Azow/Capstone-Robot-Camera-Arm/src/arm_description_v2/meshes/Carriage.STL

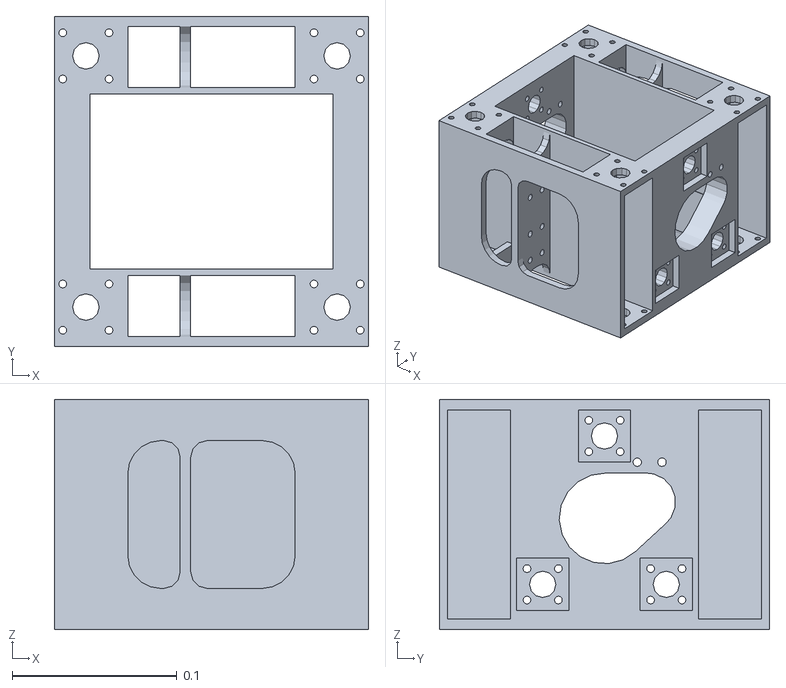
[picture p1: CAD file, 2026-10-30]
src/arm_description_v2/meshes/Carriage.STL
0.191 x 0.2 x 0.14
