Azow/Capstone-Robot-Camera-Arm/src/arm_description_v2/Robotic Camera Arm Prototype Assem 1.SLDASM/meshes/Yaw_Gimbal.STL

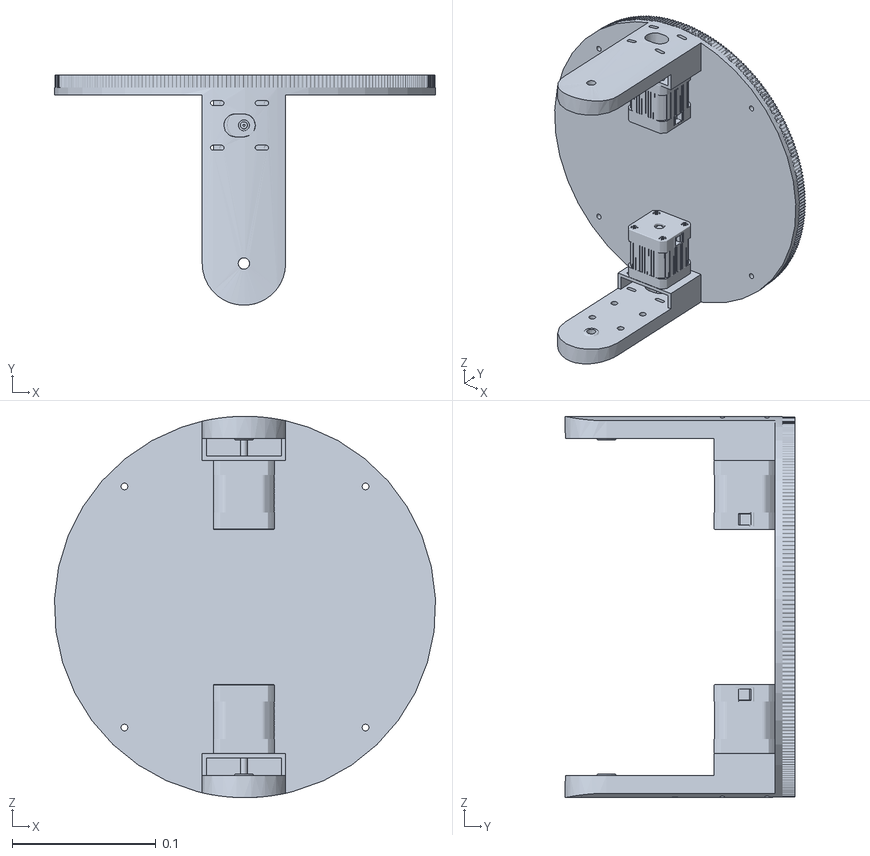
[picture p2: CAD file, 2026-10-30]
src/arm_description_v2/Robotic Camera Arm Prototype Assem 1.SLDASM/meshes/Yaw_Gimbal.STL
0.265 x 0.16 x 0.265
