Azow/Capstone-Robot-Camera-Arm/src/arm_description_v2/meshes/base_link.STL

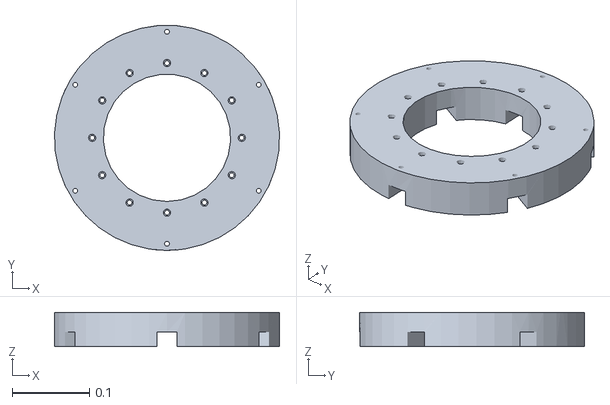
[picture p3: CAD file, 2026-10-30]
src/arm_description_v2/meshes/base_link.STL
0.292 x 0.292 x 0.0445
