Azow/Capstone-Robot-Camera-Arm/src/arm_description_v2/Robotic Camera Arm Prototype Assem 1.SLDASM/meshes/Rotating_Base.STL

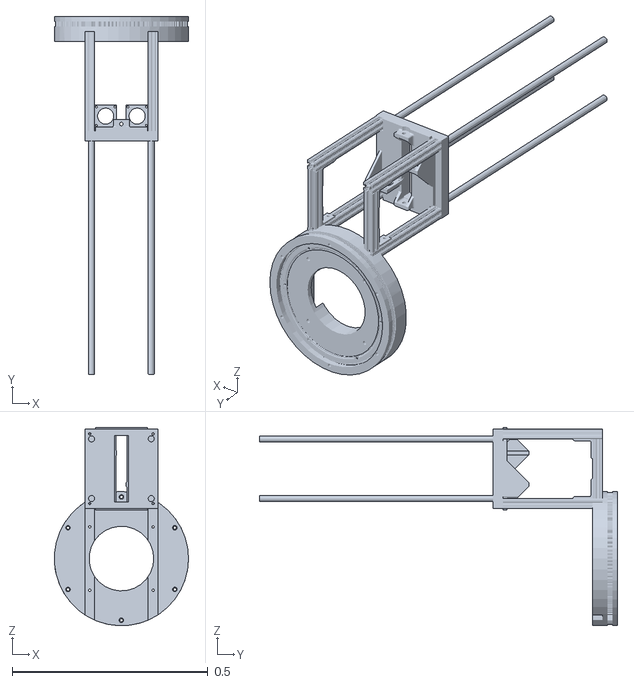
[picture p4: CAD file, 2026-10-30]
src/arm_description_v2/Robotic Camera Arm Prototype Assem 1.SLDASM/meshes/Rotating_Base.STL
0.342 x 0.914 x 0.507
