Azow/Capstone-Robot-Camera-Arm/src/arm_description_v2/Robotic Camera Arm Prototype Assem 1.SLDASM/meshes/Z_Arm.STL

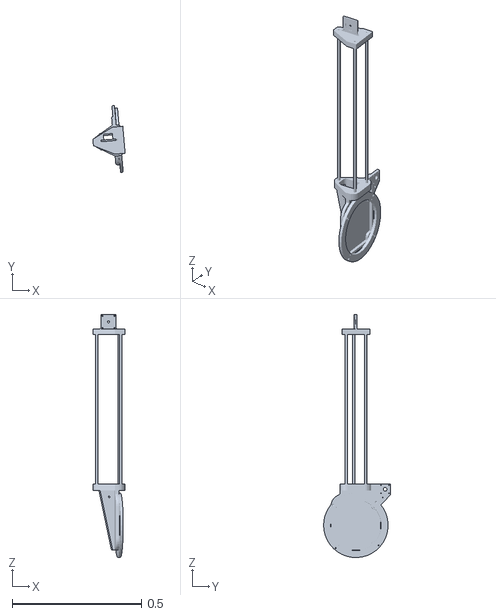
[picture p5: CAD file, 2026-10-30]
src/arm_description_v2/Robotic Camera Arm Prototype Assem 1.SLDASM/meshes/Z_Arm.STL
0.125 x 0.259 x 0.941
