Azow/Capstone-Robot-Camera-Arm/src/arm_description_v2/meshes/Pitch_Gimbal.STL

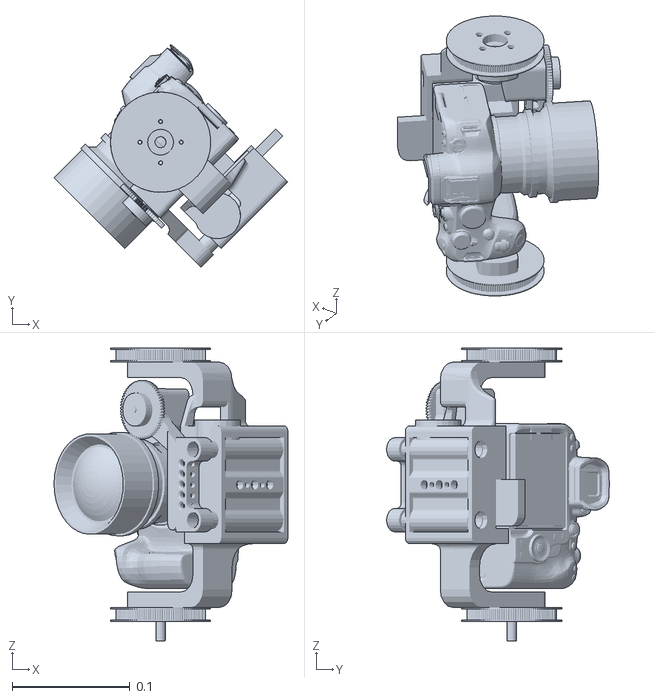
[picture p6: CAD file, 2026-10-30]
src/arm_description_v2/meshes/Pitch_Gimbal.STL
0.198 x 0.189 x 0.249
