Azow/Capstone-Robot-Camera-Arm/src/arm_description/meshes/Z_Link.STL

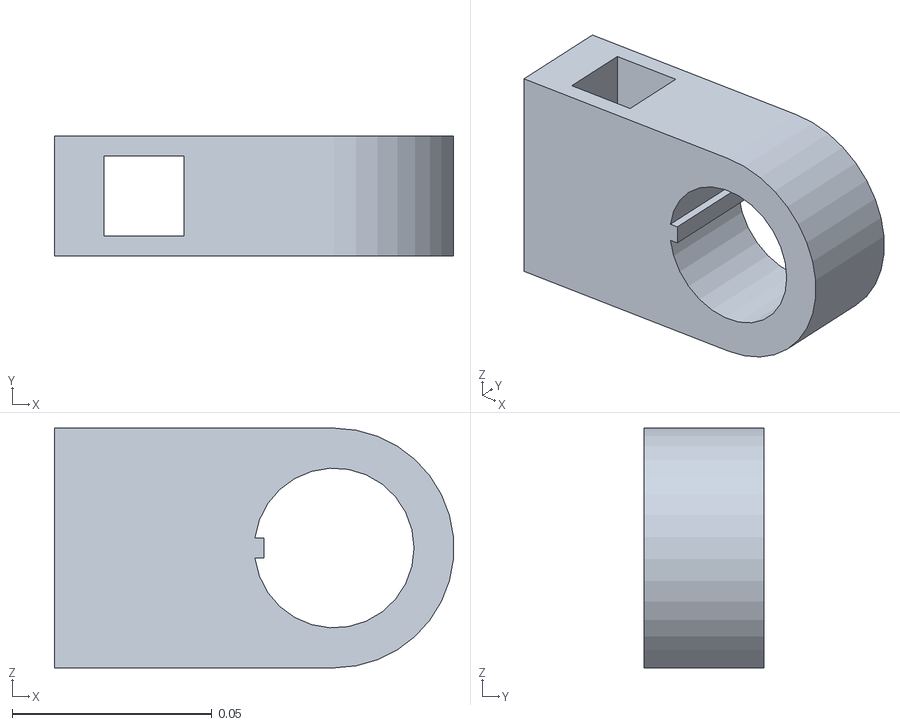
[picture p7: CAD file, 2026-10-17, an earlier design]
src/arm_description/meshes/Z_Link.STL
0.0999 x 0.03 x 0.06
