Azow/Capstone-Robot-Camera-Arm/src/arm_description/meshes/Theta_Link.STL

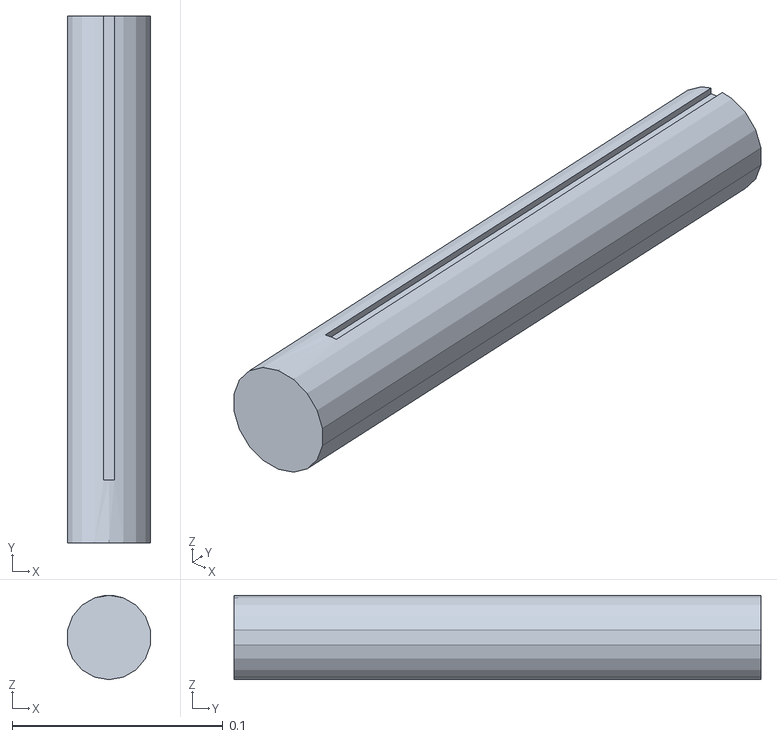
[picture p8: CAD file, 2026-10-17, an earlier design]
src/arm_description/meshes/Theta_Link.STL
0.0394 x 0.25 x 0.04
