Azow/Capstone-Robot-Camera-Arm/src/arm_description/meshes/R_Link.STL

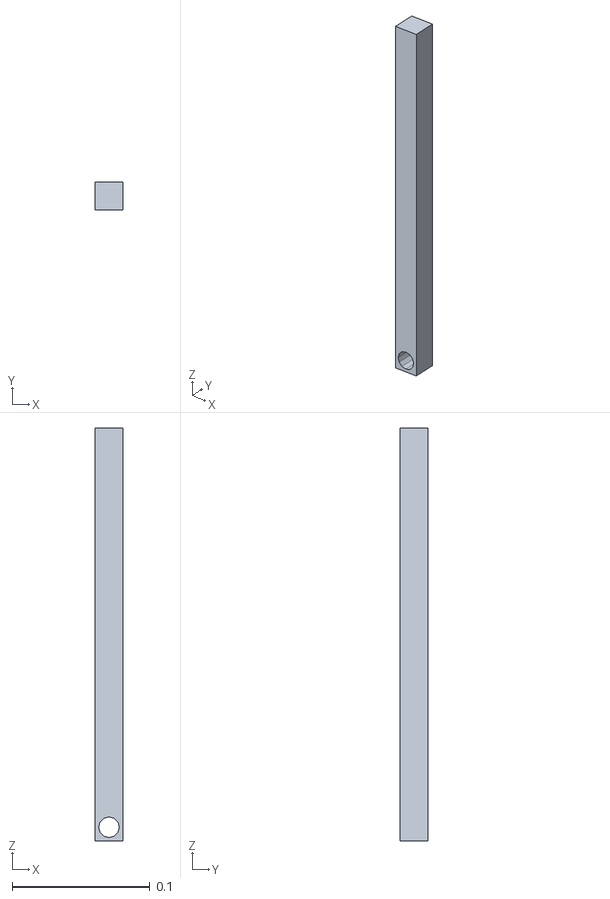
[picture p9: CAD file, 2026-10-17, an earlier design]
src/arm_description/meshes/R_Link.STL
0.02 x 0.02 x 0.3
