Azow/Capstone-Robot-Camera-Arm/src/arm_description/meshes/Cpitch_Link.STL

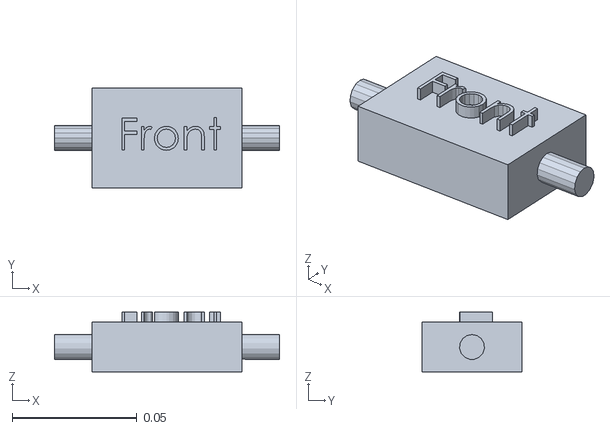
[picture p10: CAD file, 2026-10-17, an earlier design]
src/arm_description/meshes/Cpitch_Link.STL
0.09 x 0.04 x 0.024
