Azow/Capstone-Robot-Camera-Arm/src/arm_description/meshes/base_link.STL

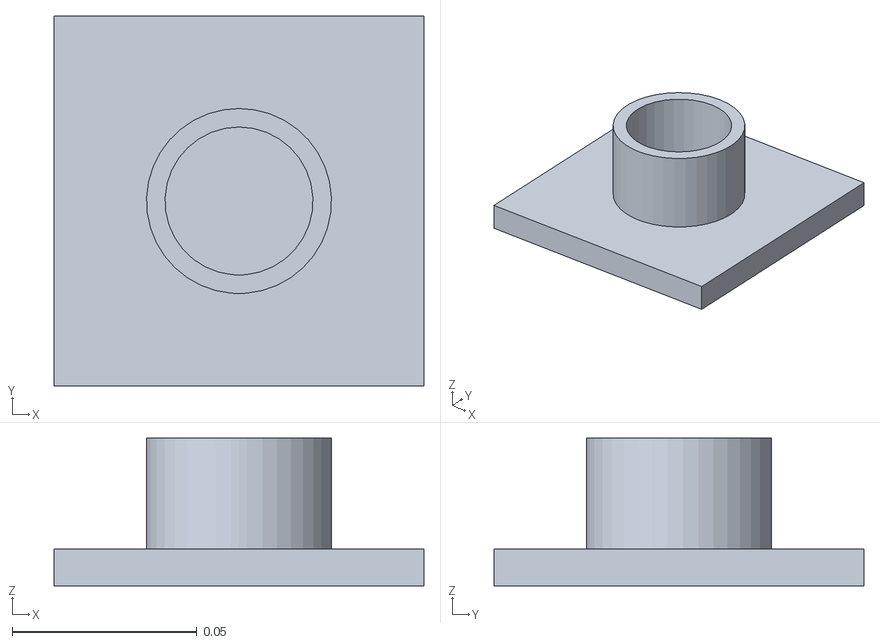
[picture p11: CAD file, 2026-10-17, an earlier design]
src/arm_description/meshes/base_link.STL
0.1 x 0.1 x 0.04
