Azow/Capstone-Robot-Camera-Arm/src/arm_description/meshes/CYaw_Link.STL

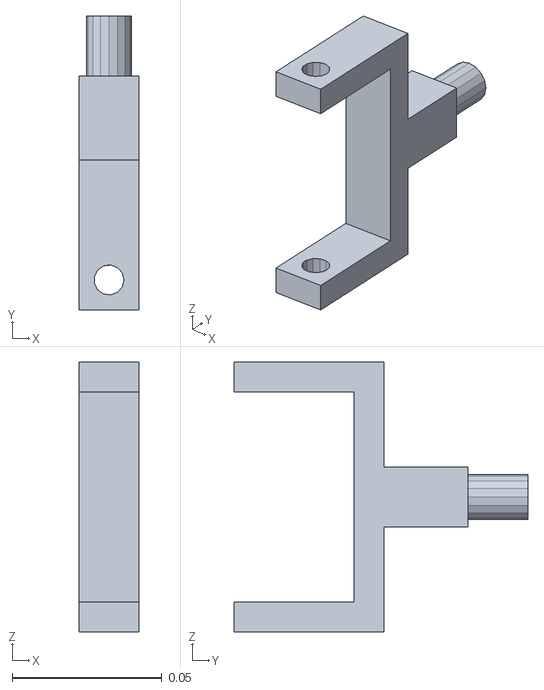
[picture p12: CAD file, 2026-10-17, an earlier design]
src/arm_description/meshes/CYaw_Link.STL
0.02 x 0.098 x 0.09
