Azow/Capstone-Robot-Camera-Arm/src/arm_description_v2/urdf/camera_arm_v2.urdf

<?xml version="1.0" encoding="utf-8"?>
<!-- This URDF was automatically created by SolidWorks to URDF Exporter! Originally created by Stephen Brawner (brawner@gmail.com) 
     Commit Version: 1.6.0-4-g7f85cfe  Build Version: 1.6.7995.38578
     For more information, please see http://wiki.ros.org/sw_urdf_exporter -->
<robot name="camera_arm_v2">
  <link name="base_link">
    <inertial>
      <origin xyz="-2.27782660584949E-10 3.67005299113982E-09 -0.0210125272705798" rpy="0 0 0" />
      <mass value="1.81215211898536" />
      <inertia ixx="0.01313648481332" ixy="7.31803112692465E-12" ixz="6.84453383261944E-12" iyy="0.0131364864971961" iyz="-1.10279680792859E-10" izz="0.025692073964106" />
    </inertial>
    <visual>
      <origin xyz="0 0 0" rpy="0 0 0" />
      <geometry>
        <mesh filename="package://arm_description_v2/meshes/base_link.STL" />
      </geometry>
      <material name="">
        <color rgba="0.894117647058823 0.894117647058823 0.894117647058823 1" />
      </material>
    </visual>
    <collision>
      <origin xyz="0 0 0" rpy="0 0 0" />
      <geometry>
        <mesh filename="package://arm_description_v2/meshes/base_link.STL" />
      </geometry>
    </collision>
  </link>
  <link name="Rotating_Base">
    <inertial>
      <origin xyz="3.04735280424216E-05 -0.152130732158363 0.0955721763812684" rpy="0 0 0" />
      <mass value="4.87575599308676" />
      <inertia ixx="0.0483683795699628" ixy="-4.26006723949936E-07" ixz="0.000165780524787756" iyy="0.0634809996326897" iyz="2.5596619675937E-09" izz="0.0483634267744175" />
    </inertial>
    <visual>
      <origin xyz="0 0 0" rpy="0 0 0" />
      <geometry>
        <mesh filename="package://arm_description_v2/meshes/Rotating_Base.STL" />
      </geometry>
      <material name="">
        <color rgba="0.752941176470588 0.752941176470588 0.752941176470588 1" />
      </material>
    </visual>
    <collision>
      <origin xyz="0 0 0" rpy="0 0 0" />
      <geometry>
        <mesh filename="package://arm_description_v2/meshes/Rotating_Base.STL" />
      </geometry>
    </collision>
  </link>
  <!-- TEMPORARY: continuous (no angle limits) for testing. Was revolute;
       the original limits are still in <limit> below (ignored while continuous). -->
  <joint name="Theta" type="continuous">
    <origin xyz="0 0 0" rpy="-1.5707963267949 0 -1.5707963267949" />
    <parent link="base_link" />
    <child link="Rotating_Base" />
    <axis xyz="0 -1 0" />
    <limit lower="-3.14" upper="3.14" effort="10" velocity="1" />
  </joint>
  <link name="Carriage">
    <inertial>
      <origin xyz="-0.0936300572129703 0.0994271100678407 0.0712083013756296" rpy="0 0 0" />
      <mass value="1.06103036578235" />
      <inertia ixx="0.00642130943103423" ixy="-1.41506940035976E-06" ixz="3.78672047856759E-06" iyy="0.0074326720984421" iyz="7.46993042765627E-06" izz="0.00950828147719121" />
    </inertial>
    <visual>
      <origin xyz="0 0 0" rpy="0 0 0" />
      <geometry>
        <mesh filename="package://arm_description_v2/meshes/Carriage.STL" />
      </geometry>
      <material name="">
        <color rgba="1 1 1 1" />
      </material>
    </visual>
    <collision>
      <origin xyz="0 0 0" rpy="0 0 0" />
      <geometry>
        <mesh filename="package://arm_description_v2/meshes/Carriage.STL" />
      </geometry>
    </collision>
  </link>
  <joint name="Z" type="prismatic">
    <origin xyz="0.10025 -0.30653 0.3248" rpy="1.5707963267949 -1.5707963267949 0" />
    <parent link="Rotating_Base" />
    <child link="Carriage" />
    <axis xyz="0 0 1" />
    <limit lower="-0.3" upper="0.45" effort="10" velocity="1" />
  </joint>
  <link name="Z_Arm">
    <inertial>
      <origin xyz="-0.0282002348257729 0.0385175442030404 -0.236030291728383" rpy="0 0 0" />
      <mass value="1.17419744975491" />
      <inertia ixx="0.0122723876023866" ixy="0.000182891002582944" ixz="0.000125744906764401" iyy="0.00970899716983699" iyz="-0.000247303091108257" izz="0.00349709266689416" />
    </inertial>
    <visual>
      <origin xyz="0 0 0" rpy="0 0 0" />
      <geometry>
        <mesh filename="package://arm_description_v2/meshes/Z_Arm.STL" />
      </geometry>
      <material name="">
        <color rgba="0.752941176470588 0.752941176470588 0.752941176470588 1" />
      </material>
    </visual>
    <collision>
      <origin xyz="0 0 0" rpy="0 0 0" />
      <geometry>
        <mesh filename="package://arm_description_v2/meshes/Z_Arm.STL" />
      </geometry>
    </collision>
  </link>
  <joint name="R" type="prismatic">
    <origin xyz="0.0943 0.06275 0.027475" rpy="-1.5707963267949 1.48162448210916 -1.5707963267949" />
    <parent link="Carriage" />
    <child link="Z_Arm" />
    <axis xyz="0 0 -1" />
    <limit lower="0" upper="0.39" effort="10" velocity="1" />
  </joint>
  <link name="Yaw_Gimbal">
    <inertial>
      <origin xyz="-0.000111647 0.0352419 1.94075e-05" rpy="0 0 0" />
      <mass value="0.789180551795657" />
      <inertia ixx="0.00671828615932125" ixy="-7.11915608134756E-06" ixz="-3.7290203563534E-10" iyy="0.00740691820330574" iyz="-8.24987037184403E-09" izz="0.00311949104679066" />
    </inertial>
    <visual>
      <origin xyz="-0.0214034 -1.49719e-06 0.125019" rpy="0 0 0" />
      <geometry>
        <mesh filename="package://arm_description_v2/meshes/Yaw_Gimbal.STL" />
      </geometry>
      <material name="">
        <color rgba="1 1 1 1" />
      </material>
    </visual>
    <collision>
      <origin xyz="-0.0214034 -1.49719e-06 0.125019" rpy="0 0 0" />
      <geometry>
        <mesh filename="package://arm_description_v2/meshes/Yaw_Gimbal.STL" />
      </geometry>
    </collision>
  </link>
  <!-- TEMPORARY: continuous (no angle limits) for testing. Was revolute;
       the original limits are still in <limit> below (ignored while continuous). -->
  <joint name="Yaw" type="continuous">
    <origin xyz="0.063543 0.0433336 -0.444201" rpy="-3.14159265358979 0 -1.48162448210916" />
    <parent link="Z_Arm" />
    <child link="Yaw_Gimbal" />
    <axis xyz="0 1 0" />
    <limit lower="-3.14" upper="3.14" effort="10" velocity="1" />
  </joint>
  <link name="Pitch_Gimbal">
    <inertial>
      <origin xyz="0.00749578 -0.0328524 -0.110687" rpy="0 0 0" />
      <mass value="0.909933018814524" />
      <inertia ixx="0.00175741888742811" ixy="2.4886447972587E-05" ixz="2.46802882684095E-05" iyy="0.00180250428027078" iyz="2.13136897634513E-06" izz="0.000847674169008528" />
    </inertial>
    <visual>
      <origin xyz="1.66585e-05 3.62442e-06 -1.04762e-10" rpy="0 0 0" />
      <geometry>
        <mesh filename="package://arm_description_v2/meshes/Pitch_Gimbal.STL" />
      </geometry>
      <material name="">
        <color rgba="0.752941176470588 0.752941176470588 0.752941176470588 1" />
      </material>
    </visual>
    <collision>
      <origin xyz="1.66585e-05 3.62442e-06 -1.04762e-10" rpy="0 0 0" />
      <geometry>
        <mesh filename="package://arm_description_v2/meshes/Pitch_Gimbal.STL" />
      </geometry>
    </collision>
  </link>
  <!-- TEMPORARY: continuous (no angle limits) for testing. Was revolute;
       the original limits are still in <limit> below (ignored while continuous). -->
  <joint name="Pitch" type="continuous">
    <origin xyz="-0.000761782 -0.0579922 0.114769" rpy="0 0 -0.785398163397449" />
    <parent link="Yaw_Gimbal" />
    <child link="Pitch_Gimbal" />
    <axis xyz="0 0 -1" />
    <limit lower="-1.57" upper="1.57" effort="10" velocity="1" />
  </joint>
  <!-- Camera optical frame (z forward, x right, y down). Lens position from SolidWorks:
       (-1, 3.356, 8.320) in from the assembly origin, centre of the lens ring on the front (+Y)
       face of the pitch gimbal, looking along +Y at the zero pose. (SolidWorks Measure shows
       unsigned deltas; x sign from the mesh.) The frame sits 2.826 in behind the lens, inside
       the camera, at (-1, 0.53, 8.320) in = (-0.0254 0.013462 0.211328) m in base_link:
       0.5 in in front of the Pitch pivot (y 0.03 in). -->
  <link name="camera_optical_frame"/>
  <joint name="camera_optical_joint" type="fixed">
    <parent link="Pitch_Gimbal"/>
    <child link="camera_optical_frame"/>
    <origin xyz="-0.010721351559766147 -0.00723566784241355 -0.11446999999999949" rpy="-1.5465200834087727 1.5707963267948966 2.380470733578473"/>
  </joint>

</robot>
