Azow/Capstone-Robot-Camera-Arm/src/arm_bridge/config/arm.yaml

# Joint units <-> motor steps, and the limits arm_bridge enforces (D-06).
#
# Motors (D-14), all 1.8 deg = 200 steps/rev, 16 microsteps (set in the firmware sketch):
#   Z1/Z2   RatRig / LDO NEMA 23, 345 oz-in, 3.0 A
#   YAW     17HS4401 NEMA 17, 1.5 A
#   PITCH   17HS4401 NEMA 17, 1.5 A (two in the CAD, one per side)
#   FOCUS   NEMA 14, 0.6 A
#   THETA   StepperOnline 23HS22-2804S NEMA 23, 1.26 N*m, 2.8 A
#   R       Lin Engineering X5718-077-20 NEMA 23, 467 oz-in, 2.0 A
#   THETA and R transmissions are still guessed (see their entries below).
# Change them here and restart arm_bridge; no re-flashing needed (but a different step
# angle or microstep setting must match the sketch).
#
# Listed in the board's joint order: THETA Z R YAW PITCH FOCUS.
#   urdf_name       joint name in camera_arm_v2.urdf and on /joint_states. FOCUS (the lens
#                   focus ring) isn't in the URDF; camera_path_ik sends it as "Focus".
#   steps_per_unit  motor steps (with microstepping) per rad, or per m for Z and R. For FOCUS,
#                   per rad of the lens's focus ring (not the motor shaft).
#   home            joint position the board calls step 0, rad or m. For now (no homing yet)
#                   this is the rest position the arm is placed in by hand before
#                   "Set home here" (D-27). Once homing exists it becomes each gate's position.
#   min, max        soft limits, rad or m (the board gets them in steps)
#   max_velocity    rad/s or m/s; paths faster than this are refused
#   max_accel       rad/s^2 or m/s^2; only used to time the move to a path's start

# TEMPORARY: position limits opened to +/-1000 for bench spin test with nothing
# attached, and max_velocity raised to just under the board's 40000 steps/s cap.
# Restore with: git checkout src/arm_bridge/config/arm.yaml
joints:
  # 23HS22-2804S NEMA 23 (1.8 deg). 200 steps/rev x 16 microsteps x 5:1 / 2 pi: the 5:1 is GUESSED.
  - {name: THETA, urdf_name: Theta, steps_per_unit: 2546.48, home: 0.0,
     min: -1000.0, max: 1000.0, max_velocity: 14.0, max_accel: 2.0}
  # NEMA 23 (1.8 deg). 200 x 16 / 0.040 m per rev: GT2 belt, 20-tooth pulley is still a GUESS.
  # Rests at the bottom (D-27).
  - {name: Z, urdf_name: Z, steps_per_unit: 80000.0, home: -0.3,
     min: -1000.0, max: 1000.0, max_velocity: 0.45, max_accel: 0.3}
  # Lin X5718-077-20 NEMA 23 (1.8 deg). Same belt GUESS as Z. Rests fully retracted (D-27).
  - {name: R, urdf_name: R, steps_per_unit: 80000.0, home: 0.0,
     min: -1000.0, max: 1000.0, max_velocity: 0.45, max_accel: 0.3}
  # 17HS4401 NEMA 17 (1.8 deg). From the CAD + McMaster parts (2026-11-07). 200 x 16 x 277/20 / 2 pi:
  # GT3 277-tooth ring on the gimbal, 3MGT 20-tooth motor pulley (McMaster 3764N128).
  # max_velocity: just under the board's 40000 steps/s cap (5.15 rad/s).
  - {name: YAW, urdf_name: Yaw, steps_per_unit: 7053.71, home: 0.0,
     min: -1000.0, max: 1000.0, max_velocity: 5.0, max_accel: 4.0}
  # 17HS4401 NEMA 17s (1.8 deg). 200 x 16 x 120/16 / 2 pi: GT2 120-tooth pulleys on the pitch shaft (McMaster 3764N123
  # size), 2MGT 16-tooth motor pulleys (McMaster 3684N11). The CAD has TWO pitch motors, one
  # per side; both must get the same steps. max_velocity: under the 40000 steps/s cap (9.5).
  - {name: PITCH, urdf_name: Pitch, steps_per_unit: 3819.72, home: 0.0,
     min: -1000.0, max: 1000.0, max_velocity: 9.0, max_accel: 4.0}
  # Lens focus ring, rad; 0 = the infinity stop, + toward close focus (camera_path_ik's
  # lens.yaml). NEMA 14 (1.8 deg). 200 x 16 x 108/60 / 2 pi: 0.8 module 60-tooth brass gear on the motor
  # (McMaster 2664N467). Lens gear ~108 teeth is ESTIMATED from the CAD (lens modeled without
  # teeth): count the teeth on the real lens. Whole 300 deg throw = 1.5 motor turns.
  # Real limits, not opened like the others: the 300 deg throw ends in hard stops on the lens.
  - {name: FOCUS, urdf_name: Focus, steps_per_unit: 916.73, home: 0.0,
     min: 0.0, max: 5.236, max_velocity: 3.0, max_accel: 10.0}
