Azow/Capstone-Robot-Camera-Arm/(commit log)

2026-10-17 Initial commit: arm_description package
    [CYaw_Link.STL, Cpitch_Link.STL, R_Link.STL, Theta_Link.STL, Z_Link.STL, base_link.STL, camera_arm.urdf]
2026-10-20 Added camera path editor which allows us to create, save, load paths and see them. Sampling is currently set to 10 points per path in the visualizer which needs to be increased later.
2026-10-30 Adding prototype arm V2
    [Carriage.STL, Pitch_Gimbal.STL, Robotic Camera Arm Prototype Assem 1.SLDASM.csv, Robotic Camera Arm Prototype Assem 1.SLDASM.urdf, Rotating_Base.STL, Yaw_Gimbal.STL, Z_Arm.STL, base_link.STL]
2026-10-30 Updating editor.launch.py for more controls -play pause -speed -remove waypoints from view -slider
    [camera_arm.urdf, camera_arm_v2.urdf]
2026-10-30 Moving the camera point to inside the camera instead of on the lens for more accuracy
    [camera_arm_v2.urdf, scene.urdf]
2026-11-01 Add speed/timing, tangent arcs and S-curve to camera paths
    [camera_arm_v2.urdf]
2026-11-01 Adding control system decision log and bring-up firmware for the Octopus Pro
    docs/control_system_decisions.md records the motor-control design decisions
    (custom serial firmware, drivers and power, homing, safety, slot assignment).
    firmware/ is a PlatformIO project for the Octopus Pro v1.1 (STM32H723):
    25 MHz clock setup, Pro v1.1 pin map, TMC5160 (SPI) / TMC2209 (UART) setup,
    and a text command shell for bring-up (PING, INFO, DRIVERS, ENABLE, SPIN,
    ENDSTOPS). Compiles; not yet tested on hardware.
2026-11-01 Add arm_bridge package with serial communication and planning functionality
    - Implemented BoardLink class for serial communication with the board, handling requests and events.
    - Created planner module to convert joint units to steps and manage timed joint paths.
    - Defined protocol for communication between arm_bridge and the board, including request formatting and parsing.
    - Added configuration file for joint parameters and limits.
    - Established package.xml and setup.py for ROS integration.
    - Developed test suite for bridge functionality and planning logic.
    - Included RViz configuration for visualizing arm movements.
    - Introduced ArmStatus message for real-time board status updates.
2026-11-05 Updating octopus board Hardware Controls
2026-11-05 Add Octopus HAL implementation, simulation, and unit tests
    - Introduced OctopusHal class for hardware interface with GPIO registers.
    - Added simulation code in sim_main.cpp to mimic firmware behavior on PC.
    - Implemented unit tests for arm_core library functionality in test_core.cpp.
    - Created a script to generate Arduino IDE compatible firmware sketch.
    - Developed a manual jogging interface for real arm control in jog_panel.py.
    - Defined MoveJoint service for joint movement commands in MoveJoint.srv.
2026-11-06 arm_bridge: configure the drivers (DRIVERS) before every ENABLE
    The Octopus drivers lose their current and microstep settings whenever motor
    power goes off, and an unconfigured TMC5160 doesn't drive its motor, so
    'Motors on' in the editor enabled the board but nothing moved unless DRIVERS
    had been typed by hand in a serial terminal first.
    - enable(True) now sends DRIVERS (3 s per-line timeout) before ENABLE.
    BAD_CMD (fake board, firmware sim) is treated as nothing to set up; silent
    drivers are named in the status message but don't block ENABLE.
    - parse_line keeps bare words in an OK reply as its message instead of
    rejecting the line (the firmware replies 'OK q=64 all drivers answered'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
    [bridge.py, link.py, protocol.py]
2026-11-07 Refactor arm_bridge protocol and configuration for testing
    - Updated the protocol.py to maintain consistency and clarity in the serial communication between arm_bridge and the board.
    - Adjusted joint limits and velocities in arm.yaml for temporary testing .
    - improved test_bridge.py to ensure comprehensive testing of the arm_bridge functionality, including motion limits, segment checks, and driver configurations.
2026-11-07 Removing platformio requirements and replacing with single arduino sketch.
    Removes the simulated board at the same time
2026-11-07 Add lens focus model and integration into IK node
2026-11-07 Update motor specifications and configurations in firmware and YAML files
2026-11-08 updating the rest of the motor settings
2026-11-08 Arduino motor arrangement and current adjustment
2026-11-13 Added joint testing and focus stall detection end stop tests
    [arm_firmware.ino, bridge.py, fake_board.py, link.py]
2026-11-13 Ardunino code bug fix
    [arm_firmware.ino]
